ahsanauddry027/CSE461_project_TrackAlert/01_09.pdf

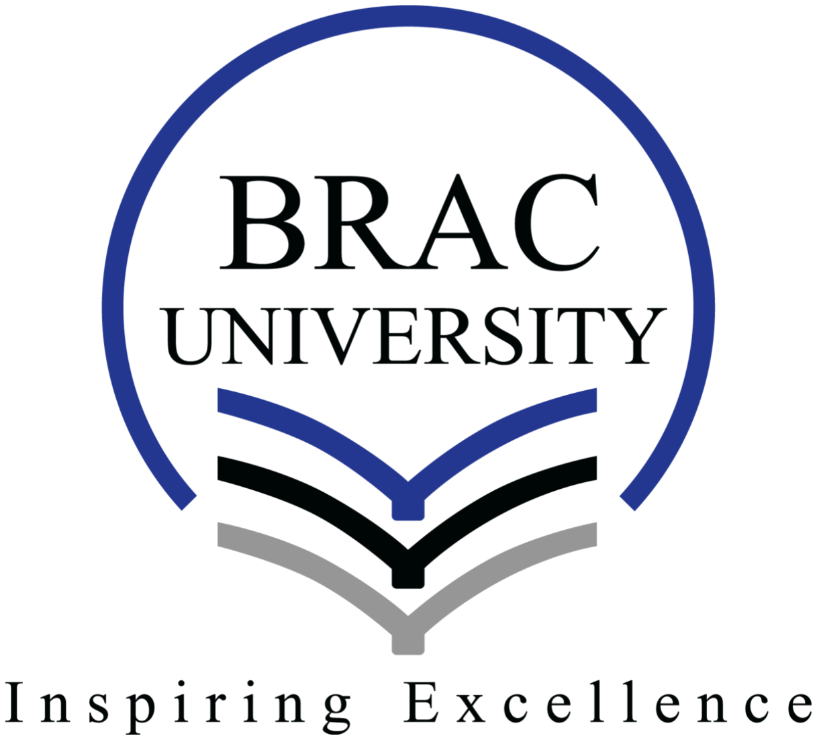
[picture p8: figure]

BRAC UNIVERSITY
CSE461: Introduction to Robotics Lab Project Report
Title: Track Alert Vision
by
Group No: 01
Section: 09
Group Members:
Name | ID
Rezowana Mehjabin Lorel | 20201089
Ahsan Habib | 22201027
Sharan Mistry | 22201779
Atahar Shihab | 22301336
Maliha Binte Shamim | 23101466

Department of Computer Science and Engineering
BRAC University
2/9/26

Abstract
TrackAlert Vision is a robot that aims to reduce the need for continuous human monitoring in controlled indoor environments such as warehouses,laboratories,workshops,storerooms,hallways and offices.It can dodge obstacles,then get back onto its route again to get to the final destination.Furthermore,it can sense human movement,check smoke levels along with gas levels of the smoke and also send live updates to a web page.This report looks at real world consequences this robot might have,where it can actually be used the value it gives,what it cannot do and how it might expand over time.The robot follows a predetermined line to navigate and uses ultrasonic sensing to detect and avoid obstacles.It also employs an MPU6050 to detect tipping or abnormal orientation.A PIR sensor provides initial motion detection,while the onboard ESP32CAM enables camera based verification,image capture and remote monitoring through a web interface.Smoke and gas sensors continuously monitor environmental conditions.

Keywords
Autonomous robotics,linefollowing,IoT,ESP32CAM,obstacle avoidance,environmental monitoring,wireless safety alerts,embedded systems.

1.Introduction
Traditional indoor security and monitoring often depend on human guards,which can be labour intensive,or fixed surveillance cameras,which lack total monitoring capabilities.Thus,TrackAlert can be a low cost monitoring solution with high return value,as it can monitor and detect smoke as well.
The main objective of the project is to build an autonomous robot that can be used as a surveillance system instead of human beings.It can detect and notify of smoke or any kind of movement.

The project aims to:

Automate indoor patrol activities.Detect human movement using an onboard camera.Monitor smoke and gas levels for potential hazards.Detect tipping or abnormal orientation using an IMU.Provide real time sensor information,camera footage and safety alerts through a wireless web interface.It integrates a microcontroller with multiple sensors,actuators and communication modules e.g IR sensors,ultrasonic sensors,PIR sensors,smoke and gas sensors,an MPU6050 IMU,motors and an ESP32 CAM.Sensor inputs are processed by the controller to make movement and safety decisions.And Motor outputs control the robot's navigation.Thus,the project demonstrates practical applications of sensor interfacing,actuator control,embedded programming,wireless communication and real time monitoring.

2.Related Work/ Inspiration

Microsoft has created an indoor Patrol Robot that can record photographs for remote viewing while following predefined routes inside the building. Knightscope, on the other hand develops more sophisticated autonomous security robots that incorporate sonar, LiDAR, thermal imaging and cameras for ongoing surveillance. This strategy is made simpler by our trackAlert vision concept, which emphasizes affordability and practical learning for regulated indoor environments.

3.Technical Approach

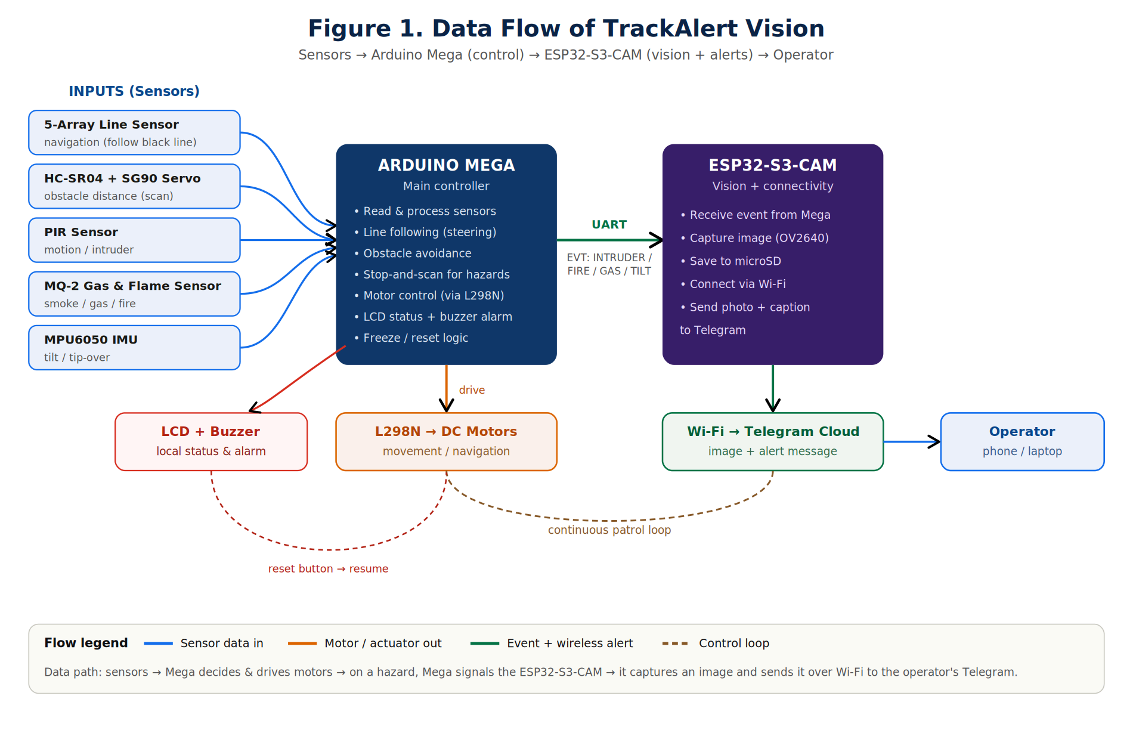
[picture p9: figure]

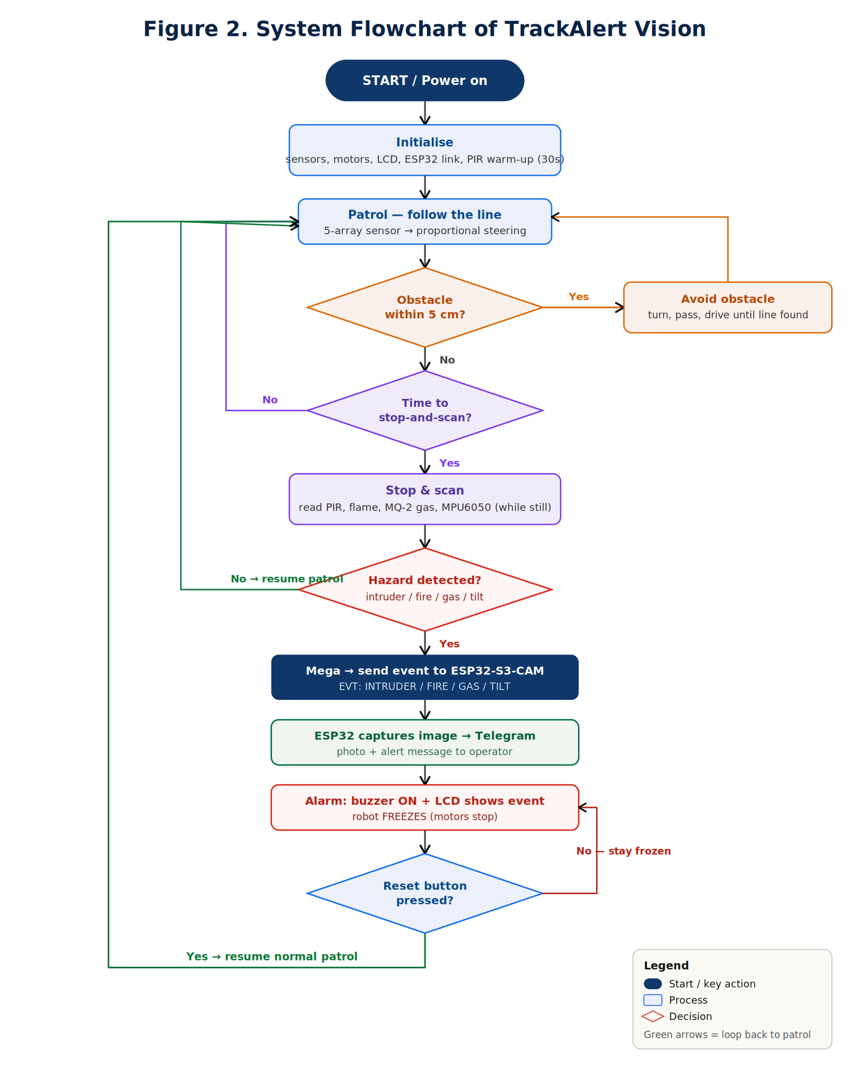
[picture p10: figure]

Components Used:

Hardware Tools:

ESP32CAM:Main controller responsible for camera operation,image capture and web interface.

IR Line Tracking Sensors:Detect the predefined path and allow the robot to follow the line.

Ultrasonic Sensor:Detects obstacles by measuring the distance between the robot and nearby objects.

MPU6050 IMU:Detects the robot's orientation,tilting and tippingover conditions.

PIR Sensor:Detects movement or human presence around the robot.MQ2 Smoke/Gas Sensor: Detects smoke and potentially harmful combustible gases.

DC Gear Motors: Provide movement

L298N Motor Driver: Controls the speed and direction of the DC motors.Robot Car Chassis and Wheels: Provide the physical structure and mobility of the robot.Battery Power Supply: Provides power to the controller,sensors and motors.Jumper Wires/Breadboard: Used for electrical connections and prototyping.

Software Tools:

Arduino IDE: Used to write,compile and upload the embedded program to the ESP32.

Embedded C/C++:Used to program the robot's movement,sensor processing,obstacle avoidance and safety logic.

ESP32 Web Server:Provides the web based interface for remotely monitoring the robot.

WiFi:Enables wireless communication between the robot and the operator's phone or laptop.

Web Interface:Displays sensor readings,camera feed,robot status,motion events and safety alerts.

Cost Breakdown:

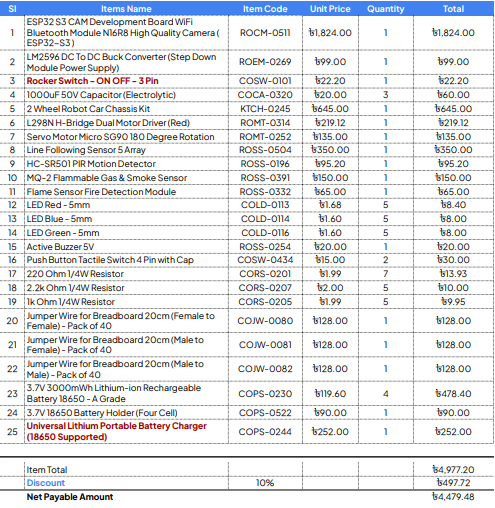
[picture p11: figure]

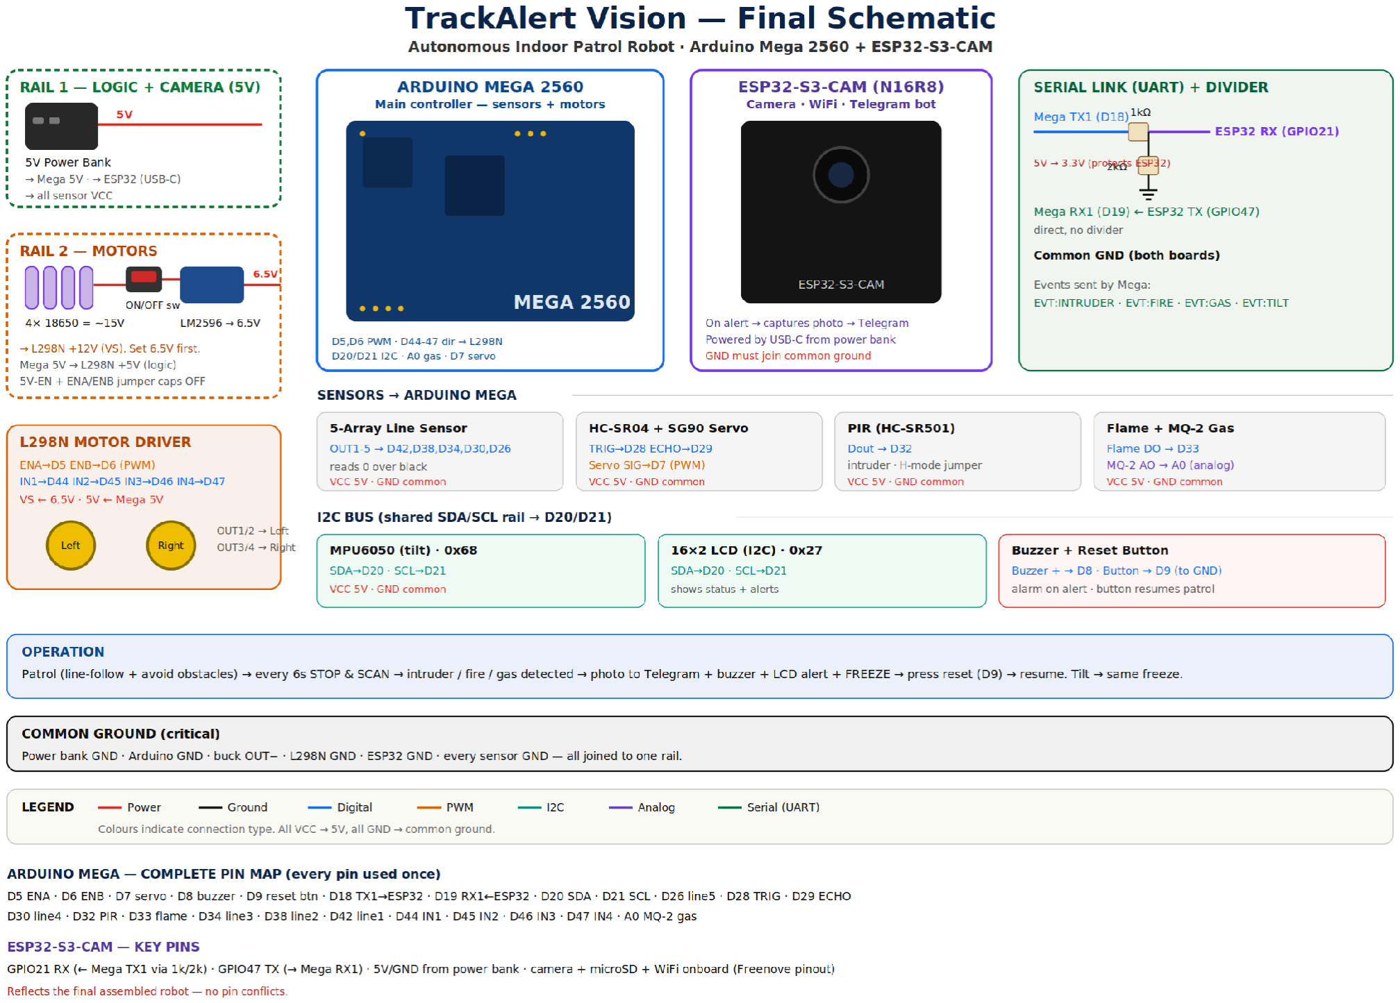
[picture p12: figure]

Figure 03: Block diagram of the project. Functionality:
TrackAlert starts by inspecting the ESP32CAM sensors,motor driver,camera and WiFi connection.The robot then begins patrolling by using IR line following sensors to follow a predefined route.While moving,the ultrasonic sensor continuously checks for obstacles.If any obstacle is detected,the robot avoids it and searches for the line again to resume its route.The MPU6050 is responsible for monitoring the robots orientation and immediately stops the motors if the robot tilts or tips over.Furthermore the PIR sensor detects movement and is verified by the camera before an alert and image are sent to the operator.The smoke sensor continuously monitors the smoke and gas levels and if it crosses a certain threshold,the robot stops and sends a safety alert.All sensor readings,robot status,camera feed and alerts are made available through a WiFi based web interface for remote monitoring.
Challenges:During development,challenges included unstable line following,difficulty recovering the route after obstacle avoidance,false PIR detections,fluctuating smoke/gas readings,robot tipping,limited ESP32CAM processing power and dependence on a physical line.These challenges were addressed through sensor calibration,improved motor control and
route | recovery | logic,camera | based | motion | verification,threshold | based | safety
detection,MPU6050 tilt monitoring,lightweight image processing and careful integration of the hardware and software components.

4.Sustainability & Impact
Sustainability:
TrackAlert Vision a low cost and energy efficient indoor monitoring system.Its line following approach reduces the computational and hardware requirements and thus does not require advanced navigation techniques such as LiDAR and SLAM,making the system simpler.Our system is simple so if any one component malfunctions,we can just replace it instead of replacing the whole robot.The chassis and many other components can be reused for other purposes. Impact:
TrackAlert Vision is a robot that aims to reduce the need for continuous human monitoring in controlled indoor environments such as warehouses,laboratories,workshops,storerooms,hallways and offices.It can dodge obstacles,then get back onto its route again to get to the final destination. Future Work:
Future development can include multiple patrol routes,scheduled patrols,industrial grade sensors,LiDAR based navigation places where no physical line exists.We can also implement improved power management and cloud based monitoring.Also,since the ESP32 CAM has limited capability,we can introduce a more powerful camera and integrate AI in our system. Limitations:
Despite such features which helps in improving human labour,the line following system depends on a physical path.So dirt or any other interruptions to the line can affect navigation.Furthermore,the ultrasonic sensors provide less environmental information than LiDAR.The current system may also have difficulty distinguishing an authorized operator from an intruder.
5.Results & Discussion
The robot was tested in an indoor environment on a black electricaltape track laid over lightcoloured floor tiles.Each subsystem was tested individually and then integrated.The linefollowing,obstacleavoidance and hazarddetection features all functioned correctly after calibration.Representative results are summarised in the table below.
Feature / Test | Result | Notes
Line following (straight + gentle curves) | Working | Stable after reversing sensor order and setting polarity (0 = black)
5 array sensor calibration | Working | All 5 sensors flip 1 (white) / 0 (black) after sensitivity tuning
Obstacle avoidance + line recovery | Working | Detect > turn > pass > drive until line redetected
PIR intruder detection | Working | Reliable at ~1 m after sensitivity tuning; checked during stop and scan

Flame detection | Working | Triggers on a nearby flame (~2050 cm)
Gas/smoke detection (MQ2) | Working | Analogue thresholdbased; requires ~30 s warmup
Tilt detection (MPU6050) | Working | Motors stop when the robot is tipped
Image capture > Telegram | Working | Photo delivered to the Telegram bot on each alert
Alert + buzzer + LCD + freeze/reset | Working | Robot freezes on alert and resumes on reset button press

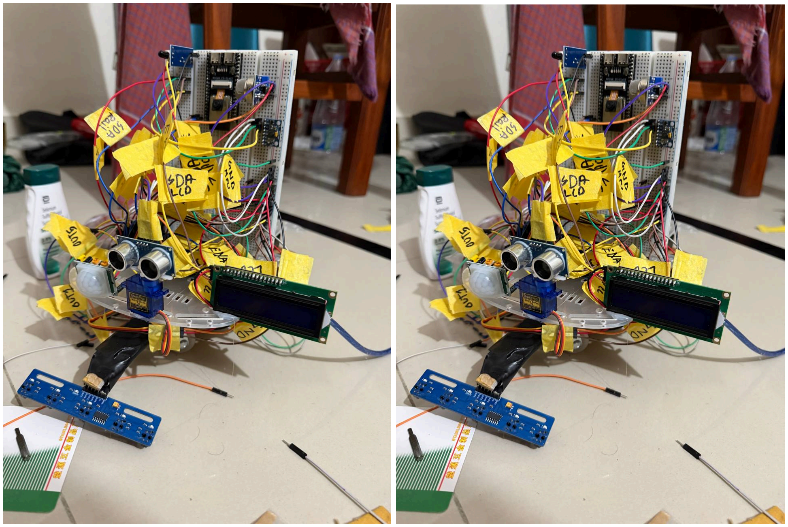
[picture p13: figure]

Figure 04: Images of the actual project

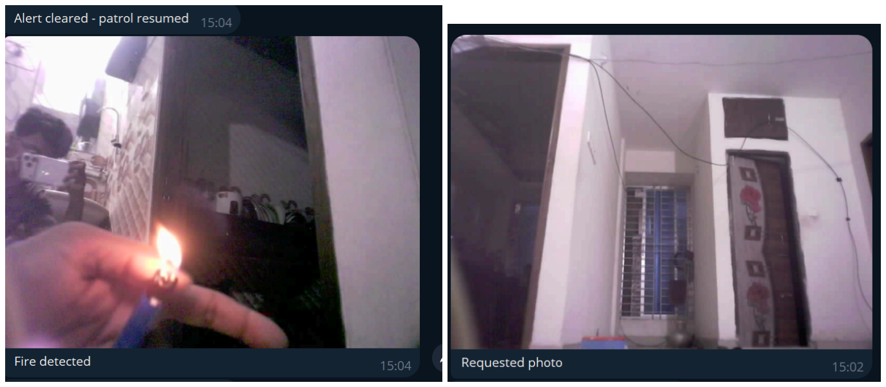
[picture p14: figure]
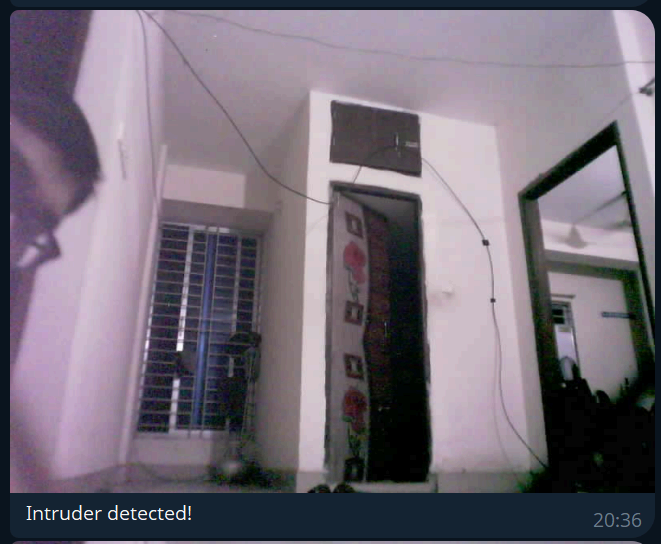
[picture p15: figure]

Figure 05: Proof of working outcome.

The results meet the project objectives: the robot patrols autonomously,avoids obstacles and recovers its route,detects intruders and hazards and reports them wirelessly with an image.The main practical difficulties: line stability,route recovery after avoidance and false PIR triggers: were resolved through sensor calibration,sensor driven (rather than purely timed) route recovery and a stop and scan strategy in which the PIR is only read while the robot is stationary.These outcomes confirm that a lowcost,lineguided platform can deliver useful autonomous monitoring without expensive navigation hardware.

6.Conclusion
TrackAlert Vision shows how a low cost autonomous robot can handle the monitoring work,while keeping humans in charge to make decisions that require real judgment.The bottom line idea of the robot,if summarised,is: to MOVE then MONITOR after that DETECT next RESPOND at the end REPORT.Even with its limits the modular setup gives a solid stepping stone for creating a better indoor inspection and observation system.

7.Contribution
Name | ID | Role(s) / Responsibilities | Specific Contributions
Rezowana Mehjabin Lorel | 20201089 | Hardware Design,Circuit Building & Power Management | Chassis & Power: chassis assembly,L298N motor driver wiring,18650 battery pack,LM2596 buck converter and common ground
Ahsan Habib | 22201027 | Hardware Design,Embedded Systems & Autonomous Navigation | Line Following: 5 array sensor and proportional steering; Obstacle Avoidance: servo + ultrasonic scanning and route recovery; Telegram Bot: image capture and alert messaging
Sharan Mistry | 22201779 | Embedded Systems,Wireless Communication & Intruder Detection | Camera & Communication: ESP32S3CAM setup (camera + WiFi),Mega ↔ ESP32 UART communication and PIRbased intruder detection with stop and scan
Atahar Shihab | 22301336 | Safety Systems,Software Integration & Documentation | Safety & Integration: MPU6050 tilt detection,overall software integration and testing and project report/documentation
Maliha Binte Shamim | 23101466 | Software Design,Environmental Monitoring & Alert Systems | Hazard Detection & Alerts: flame and MQ2 gas/smoke detection,threshold calibration,buzzer/LCD alerts and freeze until reset logic

References:
1. Arduino.(n.d.).Obstacle avoiding robot.Arduino Project Hub.Retrieved September 1,2026,from https://projecthub.arduino.cc/aakash11/obstacleavoidingrobot8018ae
2. Lough,B.(n.d.).Universal Arduino Telegram Bot library: ESP32Cam send photo example [Source code].GitHub.Retrieved September 1,2026,from https://github.com/witnessmenow/UniversalArduinoTelegramBot/blob/master/examples/ESP32/SendPhoto/ESP32Cam/ESP32Cam.ino (https://github.com/witnessmenow/Universal-Arduino-Telegram-Bot/blob/master/examples/ESP32/SendPhoto/ESP32-Cam/ESP32-Cam.ino)
3. Santos,R.,& Santos,S.(2024,June).Telegram: ESP32CAM take and send photo (Arduino IDE).Random Nerd
Tutorials.https://randomnerdtutorials.com/telegramesp32camphotoarduino/
4. Lee.(2024).Building a line follower robot with obstacle avoidance [Video].YouTube.https://www.youtube.com/watch?v=nzZRsMbKrvo
5. MA Robotic.(2022,December 13).Line follower with obstacle avoiding robot | Arduino
and L298 motor driver
[Video].YouTube.https://www.youtube.com/watch?v=4PQgjjOqJa4
6. Techatronic.(2024).Line following robot Arduino tutorial.Techatronic.https://techatronic.com/linefollowingrobotarduinotutorial/ (https://techatronic.com/line-following-robot-arduino-tutorial/)
