ahsanauddry027/CSE461_project_TrackAlert/Livephotos/ProjectPhoto1.JPG

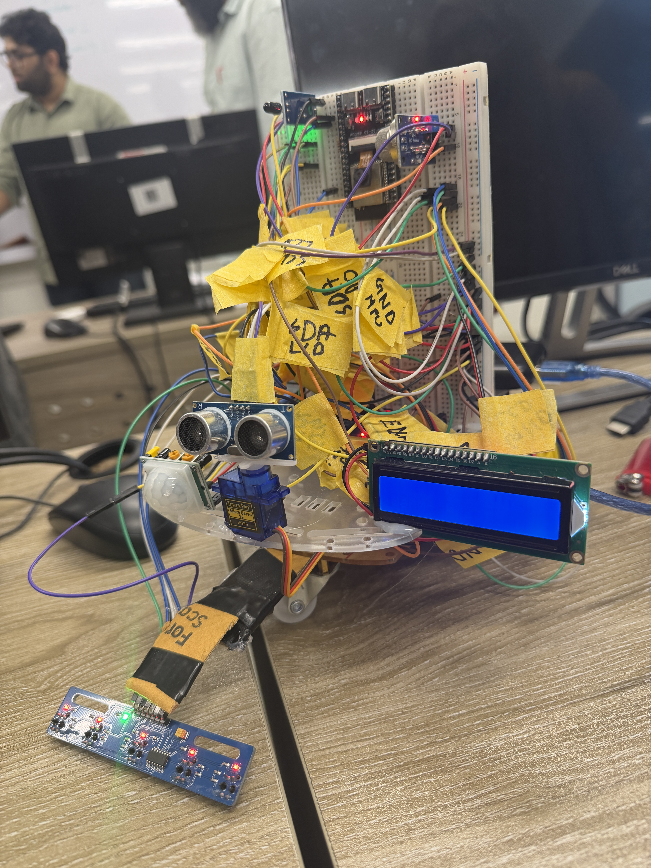
[picture p4: Livephotos/ProjectPhoto1.JPG]
Livephotos/ProjectPhoto1.JPG
