ahsanauddry027/CSE461_project_TrackAlert/Livephotos/ProjectPhoto2.JPG

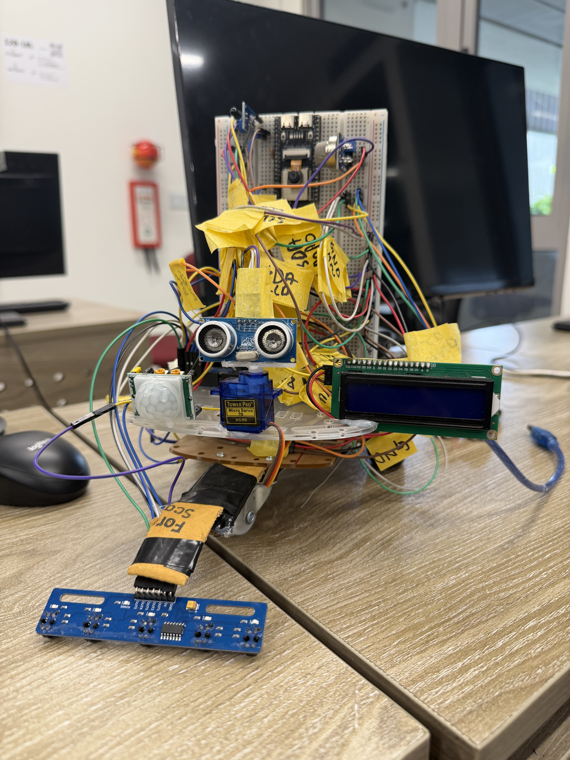
[picture p5: Livephotos/ProjectPhoto2.JPG]
Livephotos/ProjectPhoto2.JPG
